IRTrail/EREC-Mods/STEP/Encoder_Left_V_EREC.step

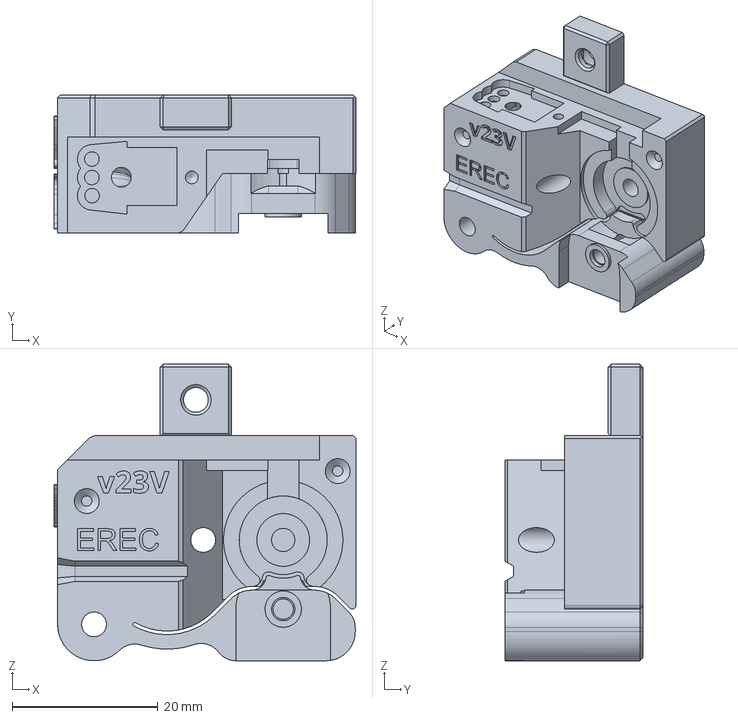
[picture p1: CAD file, 2024-06-03]
STEP/Encoder_Left_V_EREC.step
41.5 x 19.0 x 40.8 mm
