IRTrail/EREC-Mods/Solidworks/4.1 Selector Cart.SLDPRT

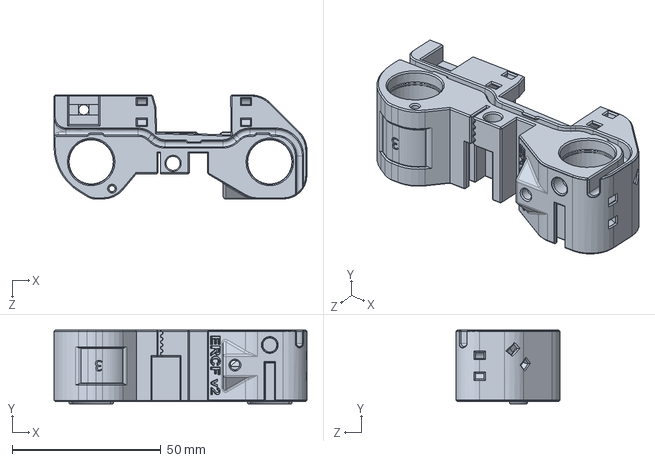
[picture p2: CAD file, 2024-06-03]
Solidworks/4.1 Selector Cart.SLDPRT
85.0 x 24.8 x 35.0 mm
