IRTrail/EREC-Mods/STEP/[a] Cutter Gear.step

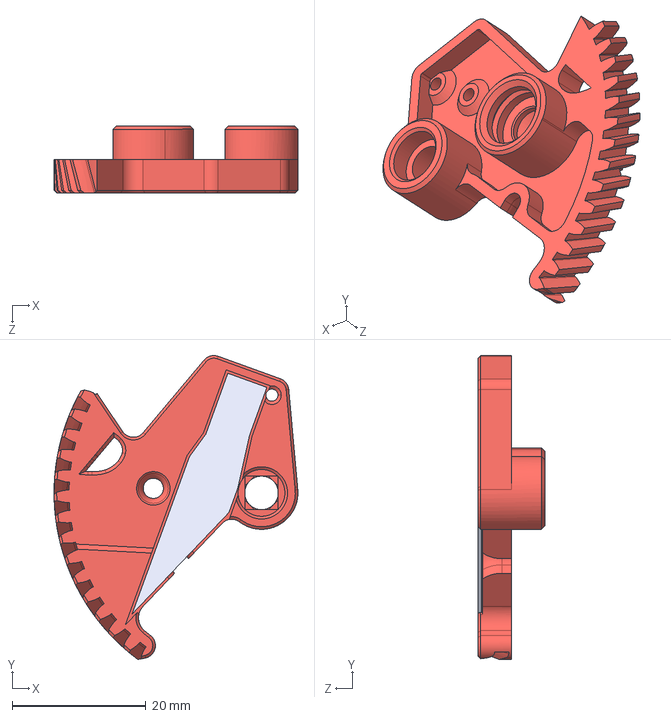
[picture p3: CAD file, 2024-06-03]
STEP/[a] Cutter Gear.step
36.4 x 45.4 x 10.0 mm
