IRTrail/EREC-Mods/STEP/Encoder_Right_V_EREC.step

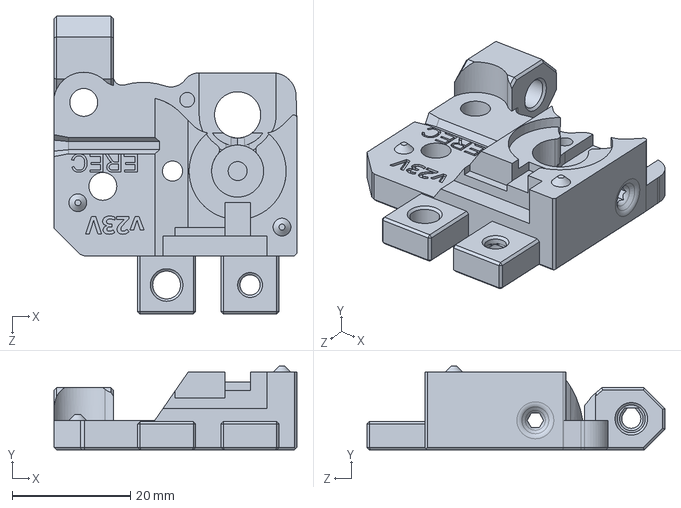
[picture p4: CAD file, 2024-05-30]
STEP/Encoder_Right_V_EREC.step
41.0 x 14.2 x 50.4 mm
