IRTrail/EREC-Mods/STEP/Idler Block.STEP

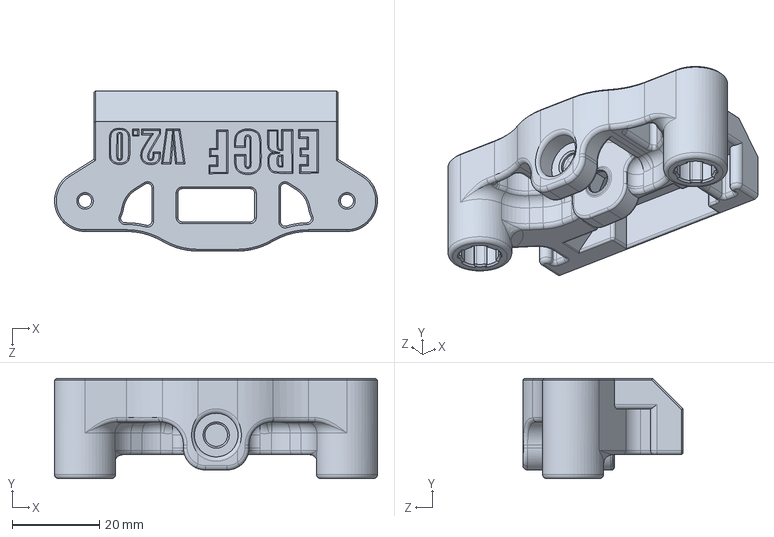
[picture p5: CAD file, 2024-05-30]
STEP/Idler Block.STEP
74.0 x 23.0 x 36.7 mm
