IRTrail/EREC-Mods/Solidworks/ã‚³ãƒ³ãƒãƒ¼ãƒãƒ³ãƒˆ7.SLDPRT

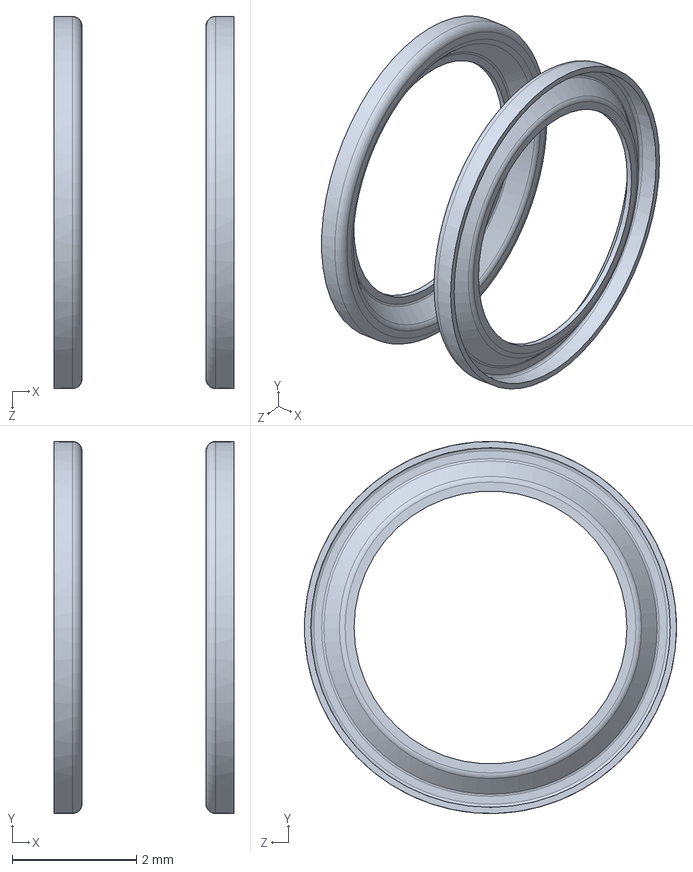
[picture p6: CAD file, 2024-06-03]
Solidworks/ã‚³ãƒ³ãƒãƒ¼ãƒãƒ³ãƒˆ7.SLDPRT
2.90 x 6.00 x 6.00 mm
