IRTrail/EREC-Mods/STEP/[a] Drive Gear.step

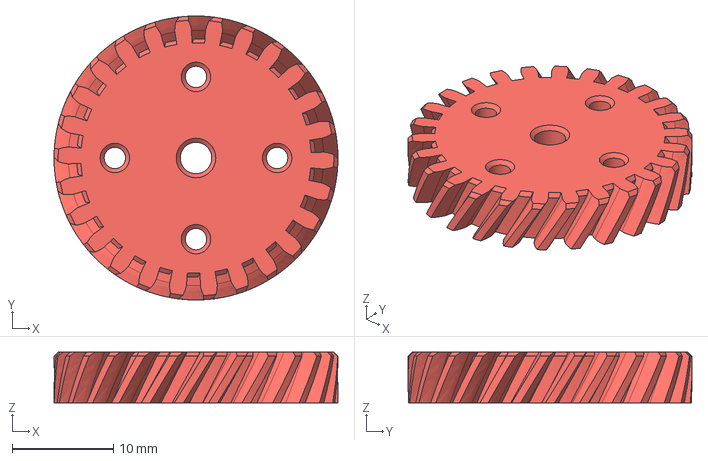
[picture p7: CAD file, 2024-05-30]
STEP/[a] Drive Gear.step
28.0 x 28.0 x 5.00 mm
