IRTrail/EREC-Mods/STEP/Servo Mount.step

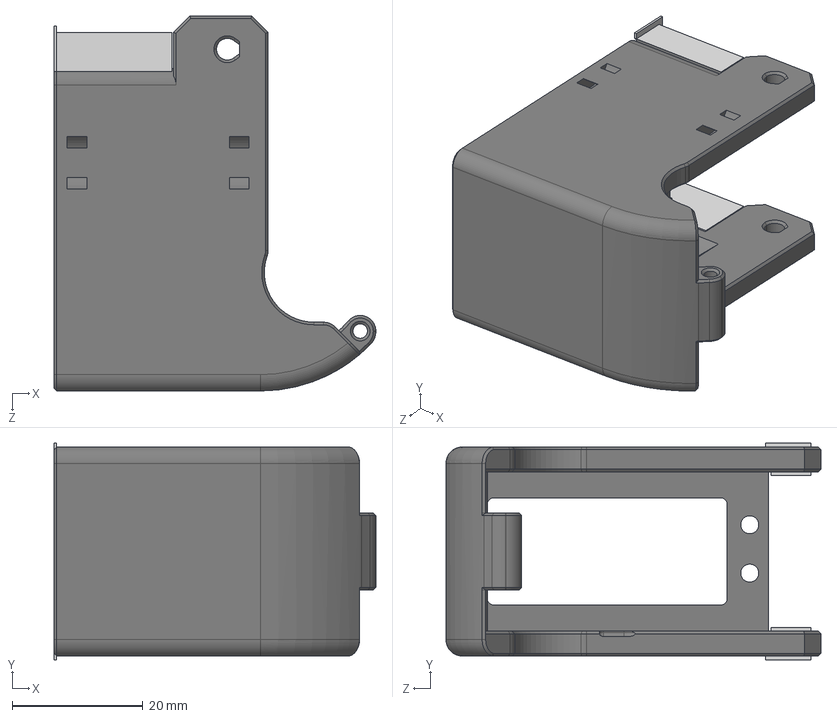
[picture p8: CAD file, 2024-05-30]
STEP/Servo Mount.step
49.2 x 33.2 x 57.4 mm
