IRTrail/EREC-Mods/Solidworks/Outer Race.SLDPRT

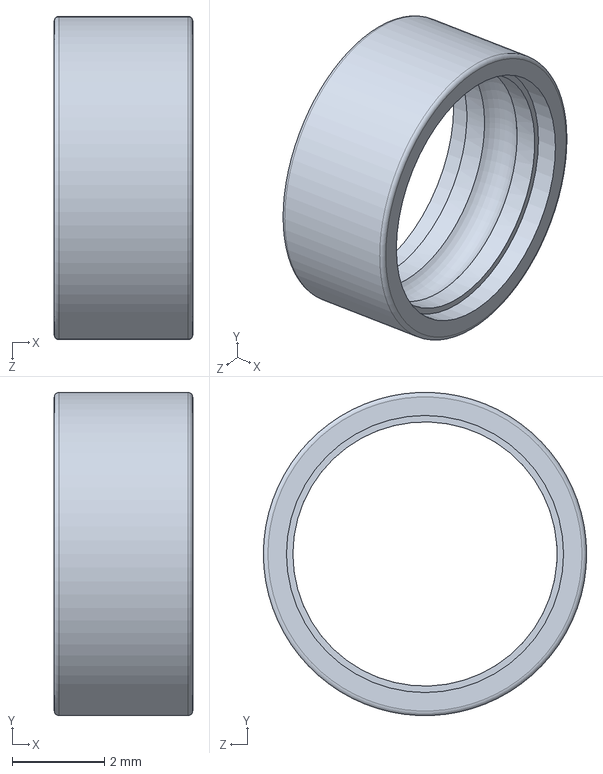
[picture p9: CAD file, 2024-06-03]
Solidworks/Outer Race.SLDPRT
3.00 x 6.99 x 7.00 mm
