IRTrail/EREC-Mods/Solidworks/Encoder Left (1).SLDPRT

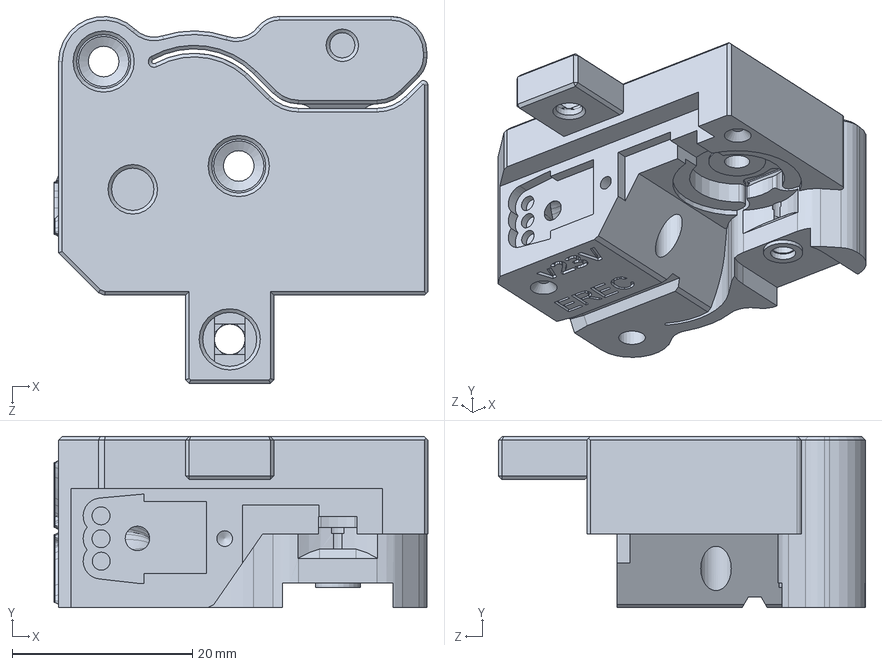
[picture p10: CAD file, 2024-05-30]
Solidworks/Encoder Left (1).SLDPRT
41.5 x 19.0 x 40.8 mm
