IRTrail/EREC-Mods/Solidworks/4.4 Selector Door.SLDPRT

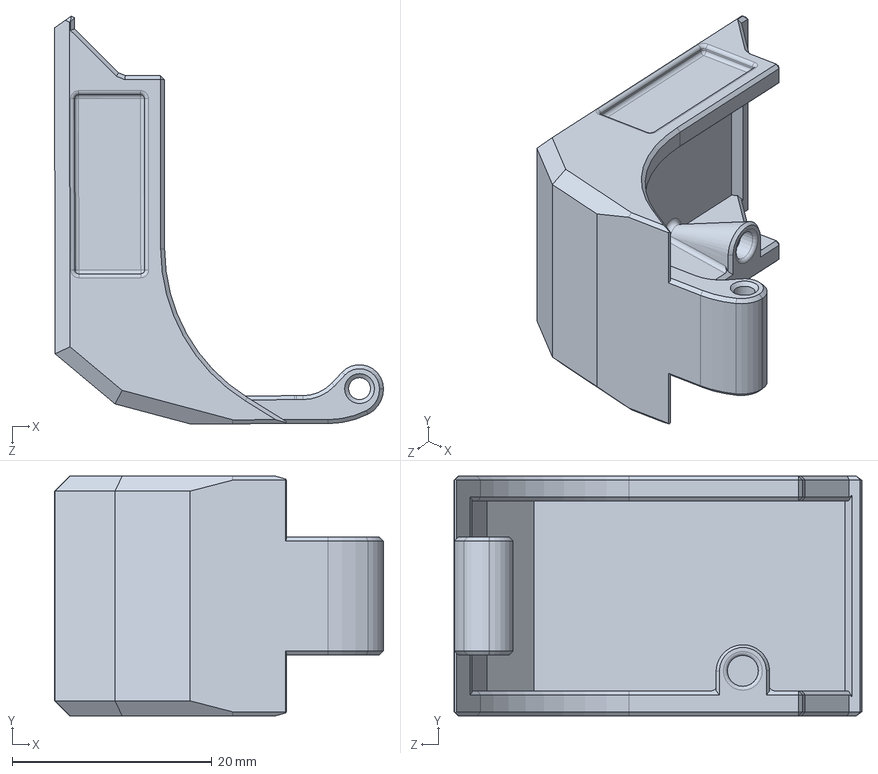
[picture p11: CAD file, 2024-05-30]
Solidworks/4.4 Selector Door.SLDPRT
33.0 x 24.0 x 40.8 mm
