IRTrail/EREC-Mods/Solidworks/4.5b Encoder for V Bearing (v23) (1).SLDASM

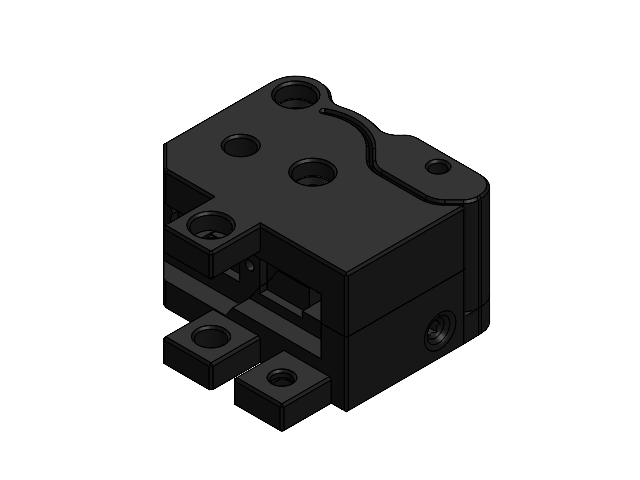
[picture p12: CAD file, 2024-06-03]
Solidworks/4.5b Encoder for V Bearing (v23) (1).SLDASM
Encoder Right (1)
Encoder_Left_V_EREC
