IRTrail/EREC-Mods/Solidworks/683ZZ Bearing.SLDASM

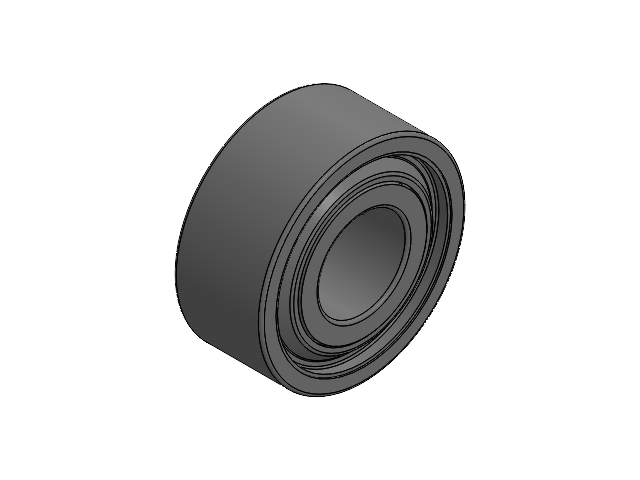
[picture p13: CAD file, 2024-06-03]
Solidworks/683ZZ Bearing.SLDASM
Outer Race
ã‚³ãƒ³ãƒãƒ¼ãƒãƒ³ãƒˆ6
ã‚³ãƒ³ãƒãƒ¼ãƒãƒ³ãƒˆ7
