IRTrail/EREC-Mods/(list of files, cad)

Other CAD files:
Solidworks/DEFAULT (3).SLDASM
Solidworks/Hardware.SLDASM
Solidworks/DS210CLHV.SLDASM
Solidworks/DS210CLHV-6.SLDPRT
Solidworks/DS210CLHV-10.SLDPRT
STEP/[a] Selector Cart.step
Solidworks/DS210CLHV-7.SLDPRT
Solidworks/ã‚³ãƒ³ãƒãƒ¼ãƒãƒ³ãƒˆ6.SLDPRT
Solidworks/DS210CLHV-0.SLDPRT
Solidworks/DS210CLHV-2.SLDPRT
Solidworks/5.2 Linear Axis Idler Block.SLDPRT
Solidworks/DS210CLHV-3.SLDPRT
Solidworks/DS210CLHV-1.SLDPRT
Solidworks/DEFAULT (2).SLDPRT
Solidworks/DS210CLHV-8.SLDPRT
Solidworks/Drive Gear.SLDPRT
Solidworks/DS210CLHV-11.SLDPRT
Solidworks/Cutter Gear.SLDPRT
Solidworks/DS210CLHV-5.SLDPRT
Solidworks/Encoder Right (1).SLDPRT
Solidworks/DS210CLHV-13.SLDPRT
Solidworks/DS210CLHV-9.SLDPRT
Solidworks/DS210CLHV-12.SLDPRT
Solidworks/DS210CLHV-4.SLDPRT
Solidworks/91290A041_Alloy Steel Socket Head Screw.SLDPRT
Solidworks/Encoder_Left_V_EREC.SLDPRT
Solidworks/Encoder_Right_V_EREC.SLDPRT
Solidworks/M2x6mm Hex Socket.SLDPRT
