IRTrail/EREC-Mods/(commit log)

2024-05-30 Initial Commit
    EREC modification for Promodeler DS210CLHV
    [Encoder_Left_V_EREC.step, Encoder_Right_V_EREC.step, Idler Block.STEP, Servo Mount.step, [a] Cutter Gear.step, [a] Drive Gear.step, [a] Selector Cart.step]
2024-06-03 Mo updates
    [4.1 Selector Cart.SLDPRT, 4.5b Encoder for V Bearing (v23) (1).SLDASM, 5.2 Linear Axis Idler Block.SLDPRT, 683ZZ Bearing.SLDASM, 91290A041_Alloy Steel Socket Head Screw.SLDPRT, Cutter Gear.SLDPRT, DEFAULT (2).SLDPRT, DEFAULT (3).SLDASM]
